AlexGyver/Arduino_Ambilight/Schemes/notebook.jpg

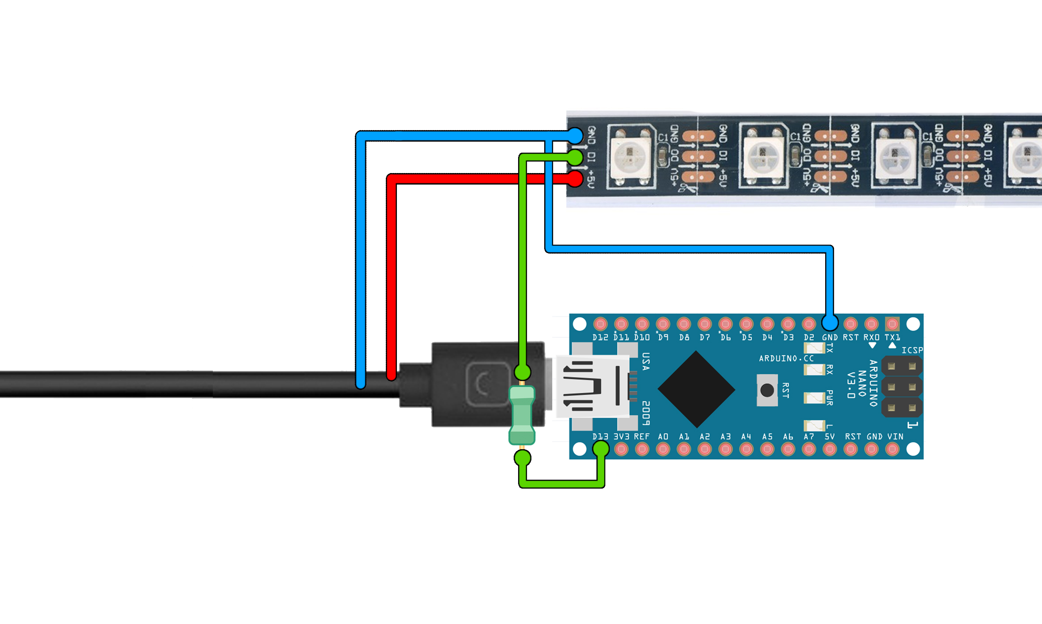
Schemes/notebook.jpg
