AlexGyver/Arduino_Ambilight/Schemes/photoResist.jpg

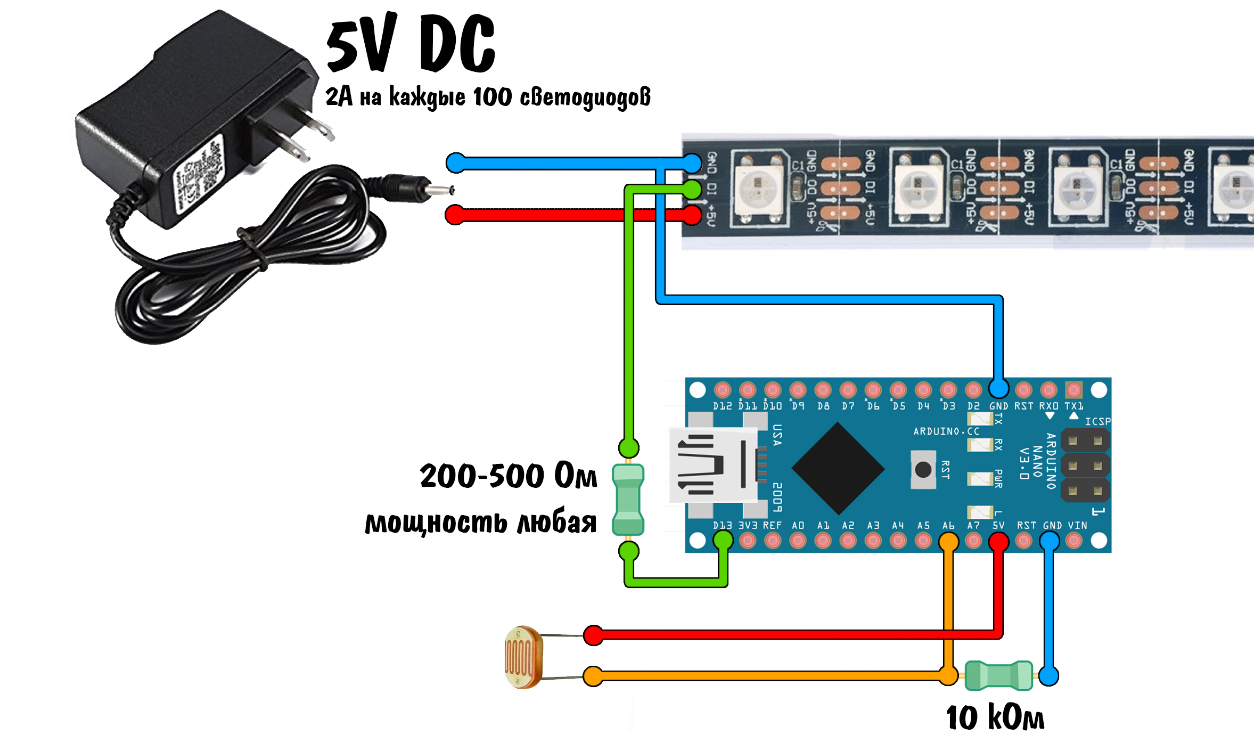
Schemes/photoResist.jpg
