AlexGyver/Arduino_Ambilight/Schemes/wiring1.jpg

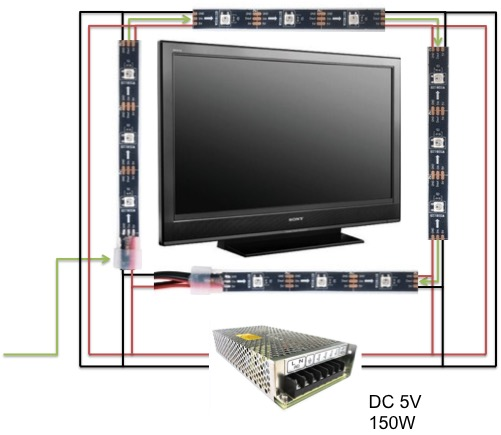
Schemes/wiring1.jpg
