AlexGyver/Arduino_Ambilight/Schemes/wiring2.jpg

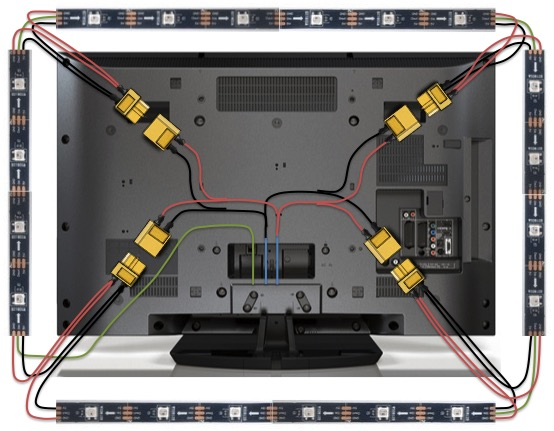
Schemes/wiring2.jpg
