AlexGyver/Arduino_Ambilight/Test pictures/Rainbow (1).jpg

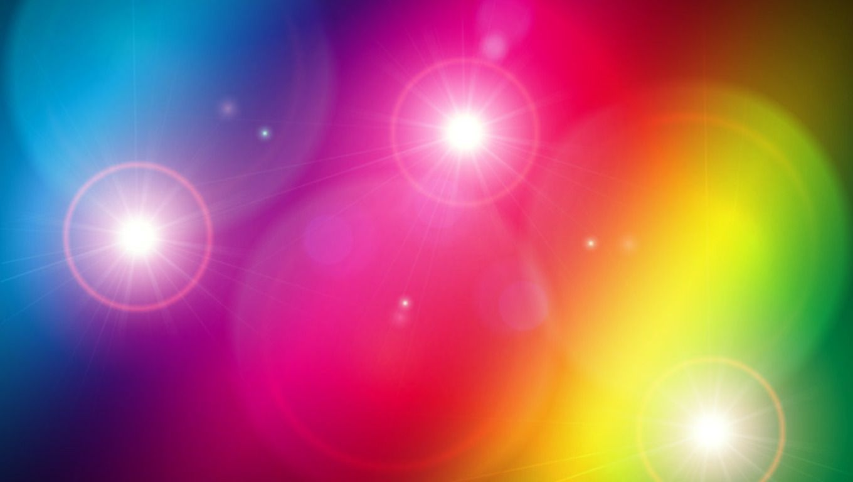
Test pictures/Rainbow (1).jpg
