AlexGyver/Arduino_Ambilight/Test pictures/Rainbow (3).jpg

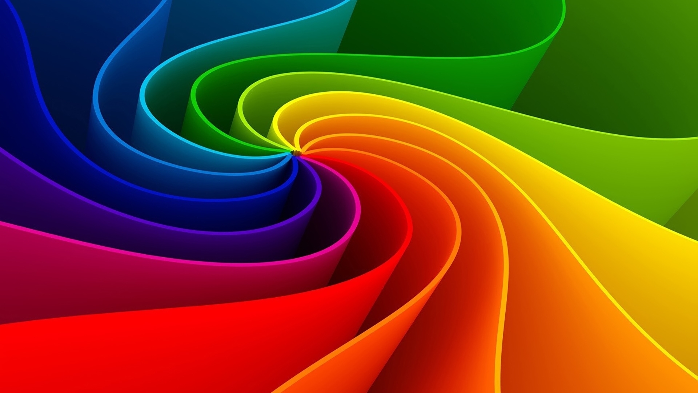
Test pictures/Rainbow (3).jpg
