AlexGyver/Arduino_Ambilight/Test pictures/Rainbow (4).jpg

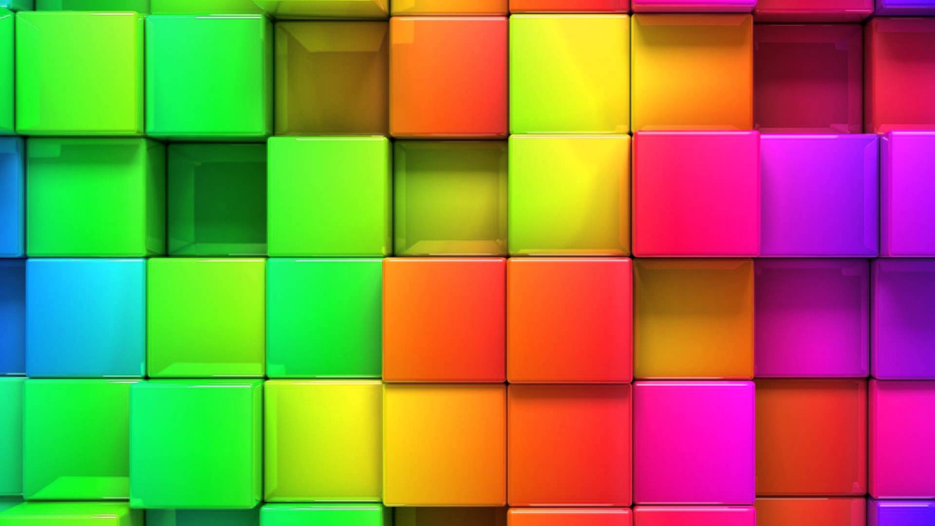
Test pictures/Rainbow (4).jpg
