AlexGyver/Arduino_Ambilight/Test pictures/Rainbow (5).jpg

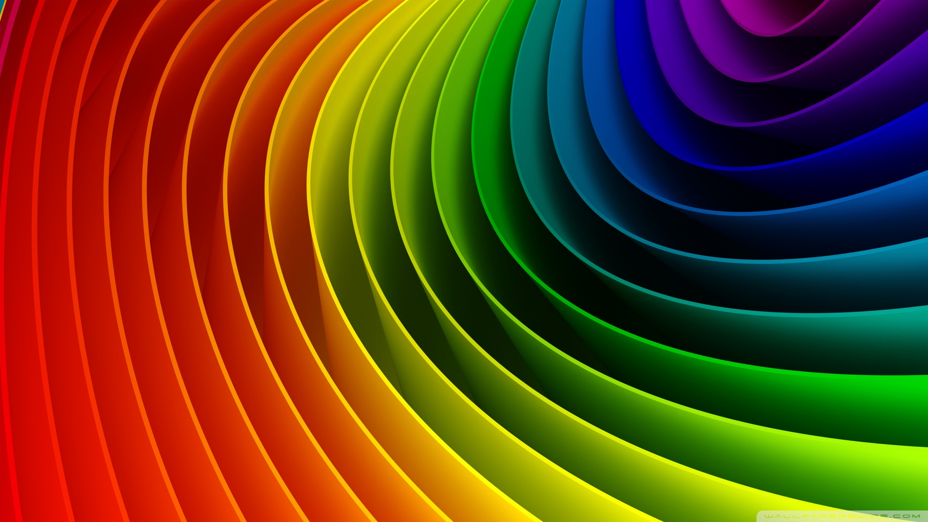
Test pictures/Rainbow (5).jpg
