AlexGyver/Arduino_Ambilight/Test pictures/Rainbow (6).jpg

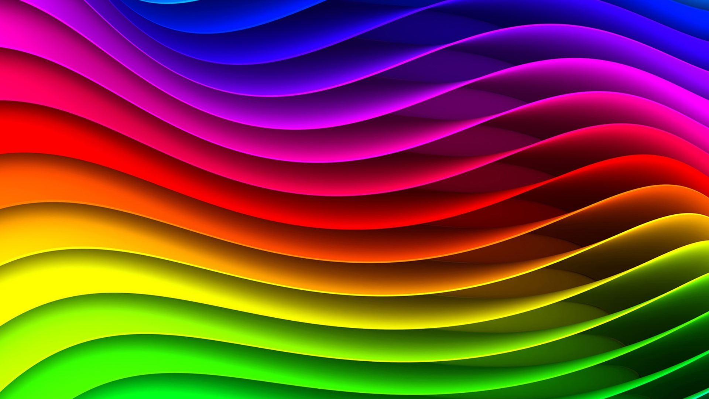
Test pictures/Rainbow (6).jpg
