AlexGyver/Arduino_Ambilight/(threads)

Thread 1 (2017-10-11):

Неадекватные led

beliavskij, 2017-10-11:
У меня какая то проблема с led лентой, в конце ленты 6 светодиодов всегда светятся (даже когда остальные выключены и программа не включена, а один в середине этого отрезка тускло светиться) , а когда включена программа, то они моргают разными цветами в случайном порядке

beliavskij, 2017-10-11:
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

beliavskij, 2017-10-11:
не заметил проблему под носом, светодиод один на ленте отходил

Closed 2017-10-11.

Thread 4 (2018-01-10):

Мигает при полной заливке экрана белым

rdavydov, 2018-01-10:
WS2812, 114 LEDs, БП 2.5А. При полной заливке экрана белым, все диоды начинают мигать примерно раз в секунду. Если переключится с белого экрана на другой (др. цвета, либо не полностью белы), эффект пропадает. К примеру, в Chrome захожу на белую about:blank , перехожу в полн. экран по F11, начинает мигать, выхожу из полн. экрана, появляется таскбар и панель вкладок, мигать перестает.
В чем может быть дело?

rdavydov, 2018-01-11:
По всей видимости, проблема в питании. Понизил яркость в Ambibox'е до 67, эффект проявился только при открытии изображения с белым фоном. Понизил до 44, эффекта пока не наблюдаю нигде. Возможно кому-то поможет.

allekss90, 2022-12-25:
> По всей видимости, проблема в питании. Понизил яркость в Ambibox'е до 67, эффект проявился только при открытии изображения с белым фоном. Понизил до 44, эффекта пока не наблюдаю нигде. Возможно кому-то поможет.

Спробуйте в скетчі змінити змінну CURRENT_LIMIT на значення 0

Figarist, 2023-09-15:
> > По всей видимости, проблема в питании. Понизил яркость в Ambibox'е до 67, эффект проявился только при открытии изображения с белым фоном. Понизил до 44, эффекта пока не наблюдаю нигде. Возможно кому-то поможет.
>
> Спробуйте в скетчі змінити змінну CURRENT_LIMIT на значення 0

Працює як часики) Тупо залишати 2000, в мене 132 лампочки і живлення від БП. Світодіоди дьоргались з цим лімітом коли вже було 15 фпс в налаштуваннях, при 10 стабільно +-, але коли лютий треш на екрані був ,відразу лаги проскакували. А без цього ліміту 60 фпс польот нормальний

Thread 7 (2022-01-29):

Сталкивался кто?

Rikded, 2022-01-29:
В общем, подсветку я сделал. Но когда открыто белое окно браузера, то светится голубым. На фото это белый цвет. Может кто подсказать, что настроить в прошивке ардуино, что бы цвета были более естественными? Я видел как лента светила белым цветом, просто что то не атк с прошивкой

EVDEDEEV, 2023-02-28:
Может питания не хватает? Чистый белый цвет потребляет больше всего

Figarist, 2023-09-15:
> Может питания не хватает? Чистый белый цвет потребляет больше всего

Я поставив собі синій в половину в налаштуваннях, а зелений з червоним по сотці, інакше нереально колір ламає. Зміну робив в additional configuring of zones -> Color correction
