AlexGyver/Arduino_Ambilight/(commit log)

2017-08-25 Динамическая подсветка для монитора
    Динамическая подсветка (Ambilight) для монитора компьютера на Ардуино
2017-08-27 обновлено
